GadgetReboot/ATTiny_HV_Programmer/Schematic_ATTiny_HV_Prog.pdf

### L1 VCC

### VCC

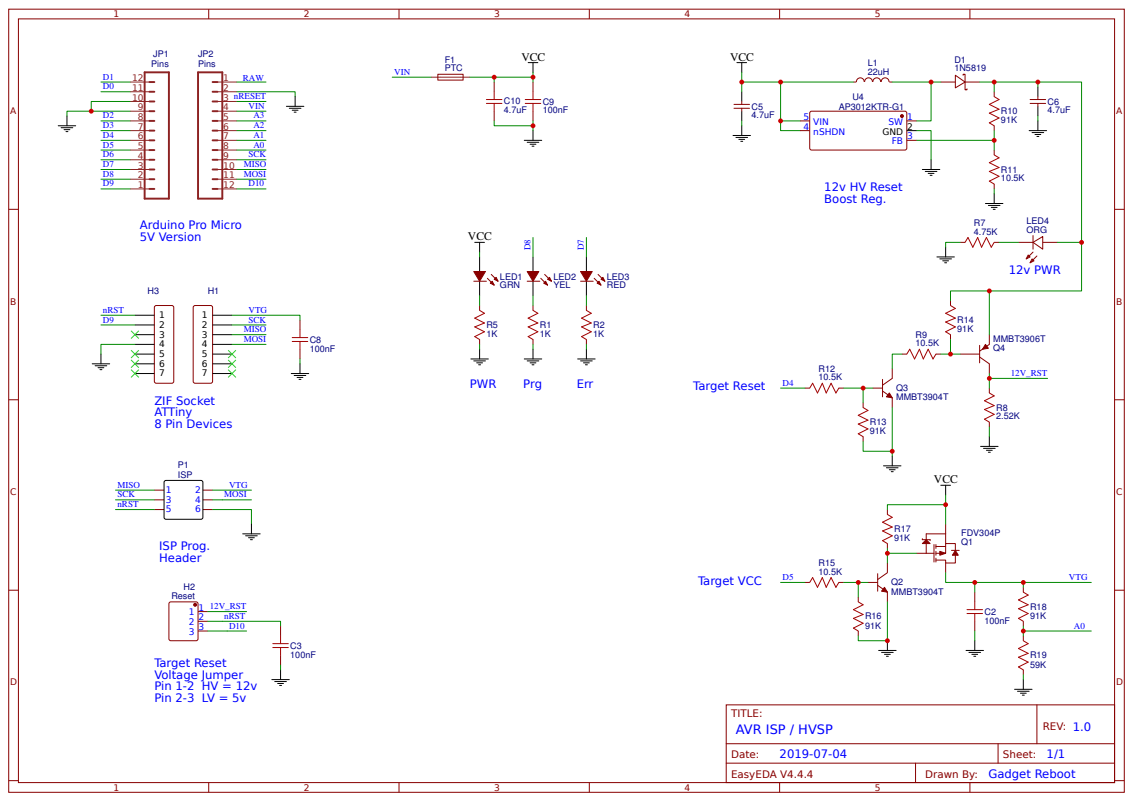
[picture p1: page 1]
