GadgetReboot/ATTiny_HV_Programmer/(threads)

Thread 1 (2021-09-21):

attiny167/87 fuse reset?

hitchhiker85, 2021-09-21:
hi i got some attiny87 and attiny167 with signature 0x0000....

cant burn with usbasp..isp..avrisp or arduino as isp.

i know the code on the chips work.. but i cant reprogramm..flash... i dont know what the fude done with the chips... but i think a fusereset with hvp will work.

is it possible?

i own a attiny167 which work.i can read fuses and signature.

but how to reprogramm?! wireing?... code.. i dont know..

please help ;)
